peterzimon/shmoergh-dual-rail-psu/README.md

# +/-12V Dual rail power supply

Based on (Banana Schplit)[https://github.com/pms67/BananaSchplit] by Philip Salmony

# History

### v0.1-not-working

- well, it doesn't work. The layout is shit

### v1

- working version, using the exact same layout as Phil with Banana Schplit

#
