peterzimon/shmoergh-dual-rail-psu/v0.1-not-working/shmoergh-dual-rail-psu.kicad_pcb

## KiCad design v0.1-not-working/shmoergh-dual-rail-psu.kicad_pcb (2023-10-03)

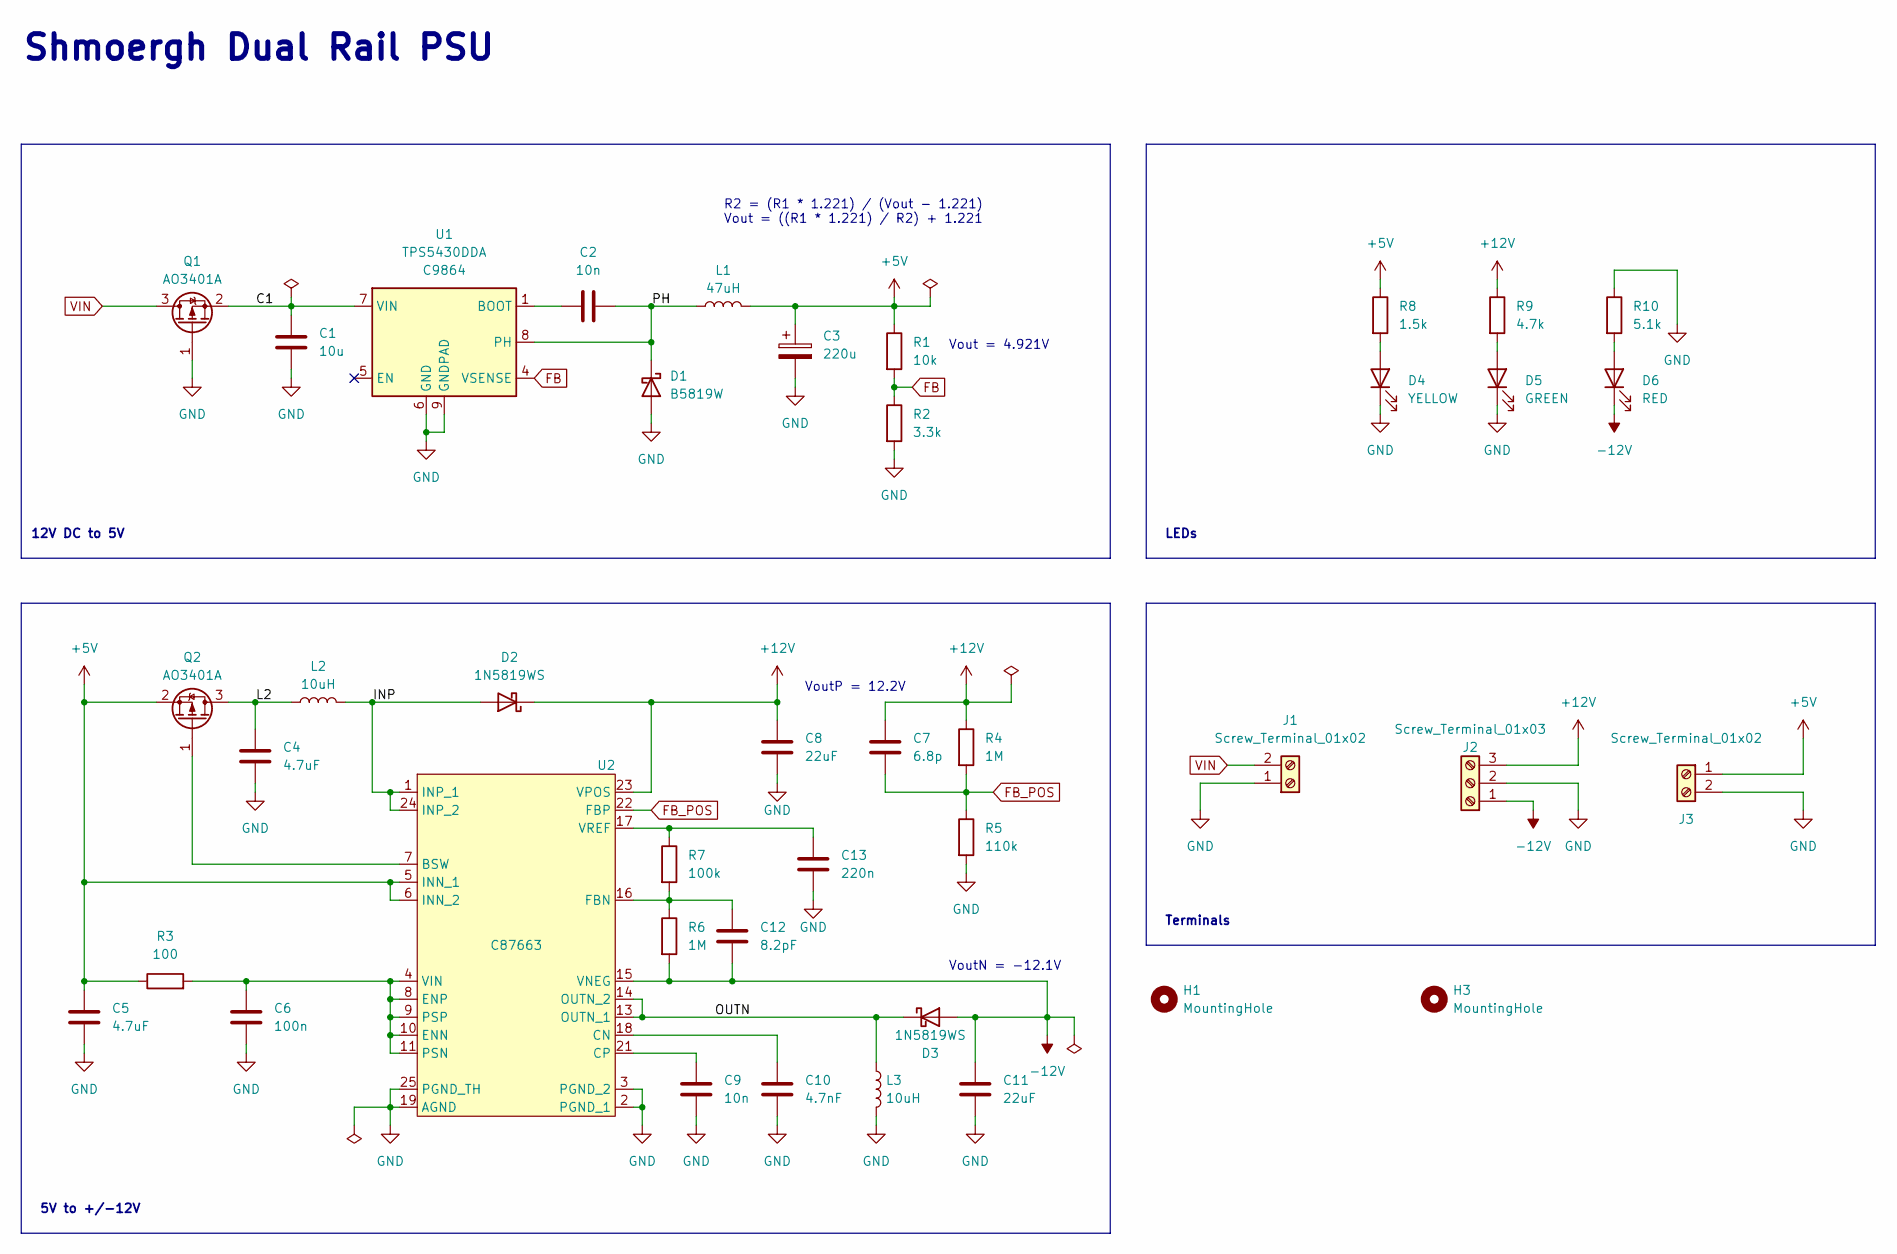
[picture p1: schematic shmoergh-dual-rail-psu.kicad_sch]

Parts:
C1: 10u; C_1206_3216Metric; LCSC C13585
C2: 10n; C_0402_1005Metric; LCSC C15195
C3: 220u; C_Elec_6.3x7.7; LCSC C127327
C4, C5: 4.7uF; C_0603_1608Metric; LCSC C19666
C6: 100n; C_0402_1005Metric; LCSC C307331
C7: 6.8p; R_0603_1608Metric; LCSC C1679
C8, C11: 22uF; C_0805_2012Metric; LCSC C45783
C9: 10n; C_0603_1608Metric; LCSC C57112
C10: 4.7nF; C_0603_1608Metric; LCSC C53987
C12: 8.2pF; C_0603_1608Metric; LCSC C1685
C13: 220n; C_0603_1608Metric; LCSC C21120
D1: B5819W; D_SOD-123; LCSC C8598
D2, D3: 1N5819WS; D_SOD-123; LCSC C191023
D4: YELLOW; LED_0603_1608Metric; LCSC C72038
D5: GREEN; LED_0603_1608Metric; LCSC C72043
D6: RED; LED_0603_1608Metric; LCSC C2286
H1, H3: MountingHole; MountingHole_3mm_Pad_Via
J1, J3: Screw_Terminal_01x02; TerminalBlock_Phoenix_MKDS-1,5-2_1x02_P5.00mm_Horizontal
J2: Screw_Terminal_01x03; TerminalBlock_Phoenix_MKDS-1,5-3_1x03_P5.00mm_Horizontal
L1: 47uH; L_Sunlord_SWRB1204S; LCSC C169398
L2, L3: 10uH; L_Sunlord_MWSA0518S; LCSC C177248
Q1, Q2: AO3401A; SOT-23; LCSC C15127
R1: 10k; R_0603_1608Metric; LCSC C25804
R2: 3.3k; R_0603_1608Metric; LCSC C22978
R3: 100; R_0603_1608Metric; LCSC C22775
R4, R6: 1M; R_0603_1608Metric; LCSC C22935
R5: 110k; R_0603_1608Metric; LCSC C25805
R7: 100k; R_0603_1608Metric; LCSC C25803
R8: 1.5k; R_0402_1005Metric; LCSC C25867
R9: 4.7k; R_0402_1005Metric; LCSC C25900
R10: 5.1k; R_0402_1005Metric; LCSC C25905
U1: TPS5430DDA; TI_SO-PowerPAD-8_ThermalVias; LCSC C9864
U2: TPS65131RGER; QFN-24-1EP_4x4mm_P0.5mm_EP2.6x2.6mm; LCSC C87663

Connections:
+5V: C3.1, C5.1, J3.1, L1.2, Q2.2 (S), R1.1, R3.1, R8.1, U2.5 (INN_1), U2.6 (INN_2)
+12V: C7.1, C8.1, D2.1 (K), J2.3, R4.1, R9.1, U2.23 (VPOS)
-12V: C11.1, C12.2, D3.2 (A), D6.1 (K), J2.1, R6.2, U2.15 (VNEG)
/C1: C1.1, Q1.2 (S), U1.7 (VIN)
/INP: D2.2 (A), L2.2, U2.1 (INP_1), U2.24 (INP_2)
/L2: C4.1, L2.1, Q2.3 (D)
/OUTN: D3.1 (K), L3.1, U2.13 (OUTN_1), U2.14 (OUTN_2)
/PH: C2.2, D1.1 (K), L1.1, U1.8 (PH)
FB: R1.2, R2.1, U1.4 (VSENSE)
FB_POS: C7.2, R4.2, R5.1, U2.22 (FBP)
GND: C1.2, C3.2, C4.2, C5.2, C6.2, C8.2, C9.2, C10.2, C11.2, C13.2, D1.2 (A), D4.1 (K), D5.1 (K), J1.1, J2.2, J3.2, L3.2, Q1.1 (G), R2.2, R5.2, R10.1, U1.6 (GND), U1.9 (GNDPAD), U2.2 (PGND_1), U2.3 (PGND_2), U2.19 (AGND), U2.25 (PGND_TH)
unnamed: D4.2 (A), R8.2
unnamed: D5.2 (A), R9.2
unnamed: D6.2 (A), R10.2
unnamed: Q2.1 (G), U2.7 (BSW)
unnamed: C2.1, U1.1 (BOOT)
unnamed: C10.1, U2.18 (CN)
unnamed: C9.1, U2.21 (CP)
unnamed: C6.1, R3.2, U2.4 (VIN), U2.8 (ENP), U2.9 (PSP), U2.10 (ENN), U2.11 (PSN)
unnamed: C12.1, R6.1, R7.2, U2.16 (FBN)
unnamed: C13.1, R7.1, U2.17 (VREF)
VIN: J1.2, Q1.3 (D)

Notes on the sheet:
R2 = (R1 * 1.221) / (Vout - 1.221) Vout = ((R1 * 1.221) / R2) + 1.221
Terminals
VoutN = -12.1V
LEDs
Vout = 4.921V
VoutP = 12.2V
12V DC to 5V
5V to +/-12V
Shmoergh Dual Rail PSU

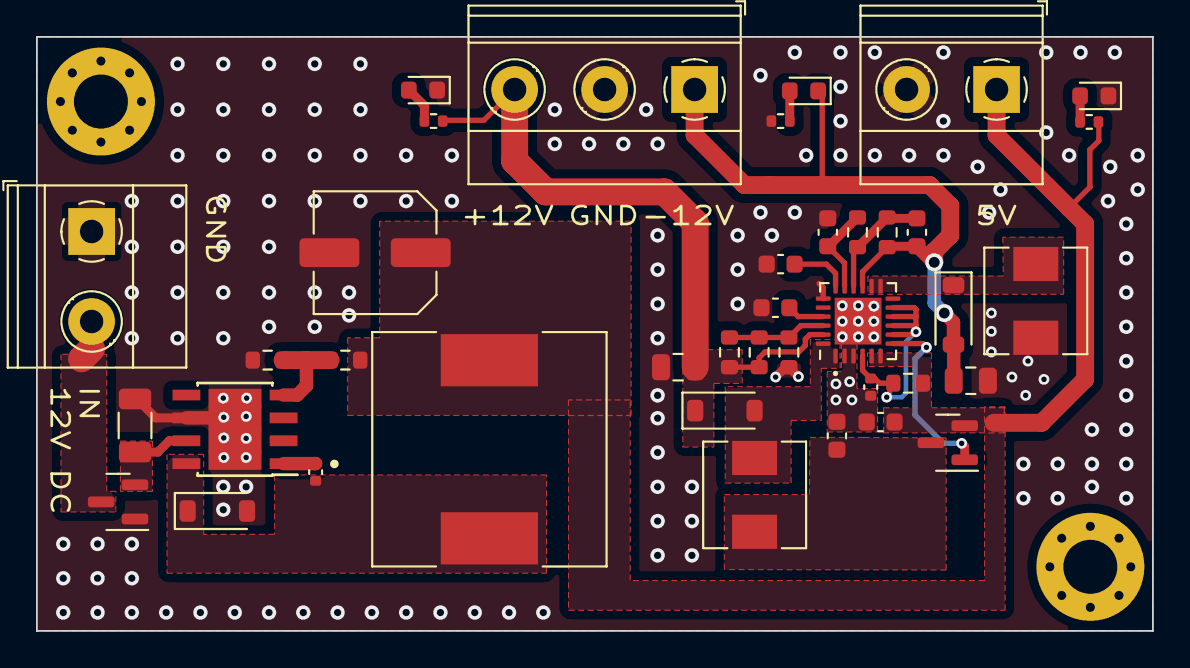
[picture p2: board v0.1-not-working/shmoergh-dual-rail-psu.kicad_pcb from above]

Board: 2 copper layers, 62.0 x 33.0 mm, 41 parts (0 on the bottom side), 22 nets.
