peterzimon/shmoergh-dual-rail-psu/v1/shmoergh-dual-rail-psu.kicad_pcb

## KiCad design v1/shmoergh-dual-rail-psu.kicad_pcb (2023-11-18)

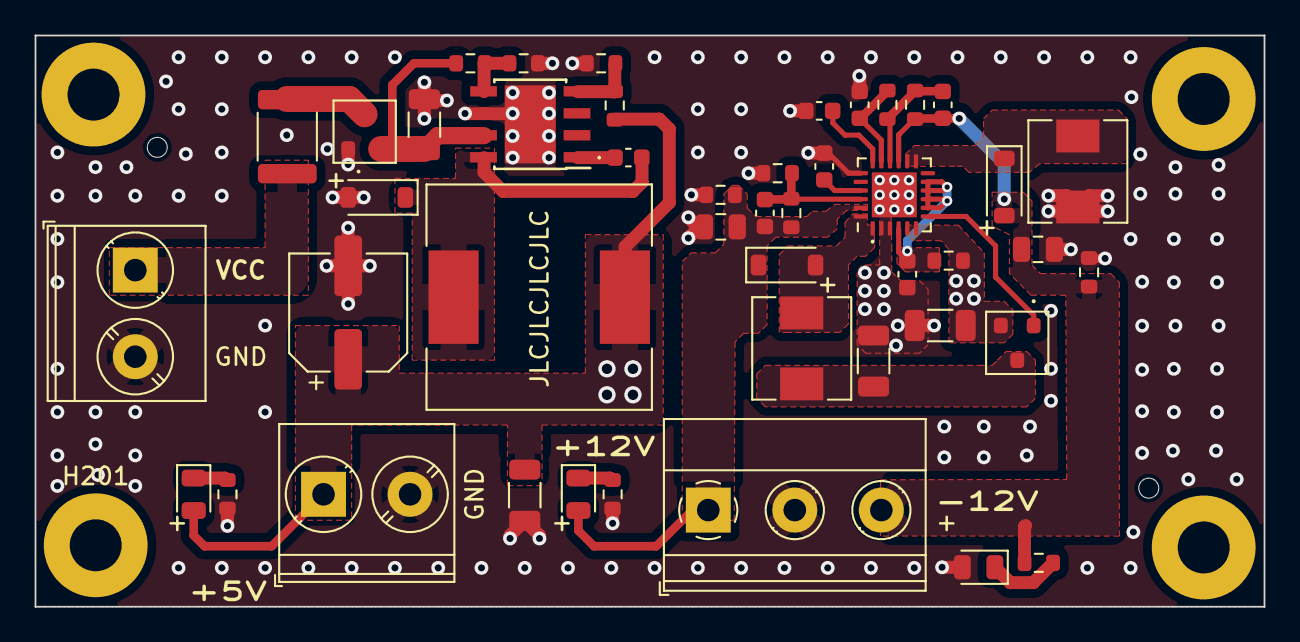
[picture p3: board v1/shmoergh-dual-rail-psu.kicad_pcb from above]

Board: 4 copper layers, 71.0 x 33.0 mm, 49 parts (0 on the bottom side), 24 nets.

Parts:
C101, C102, C103, C107: 10u; C_1206_3216Metric
C104: 100n; C_0603_1608Metric
C105, C106: 10n; C_0603_1608Metric
C108: 6p8; C_0603_1608Metric
C109: 8p2; C_0603_1608Metric
C110: 220u; CP_Elec_6.3x7.7
C111: 220n; C_0603_1608Metric
C112, C113: 22u; C_0805_2012Metric
C114: 4n7; C_0603_1608Metric
D101, D102, D103: B5819W; D_SOD-123
D104: RED; LED_0805_2012Metric
D105: GREEN; LED_0805_2012Metric
D106: YELLOW; LED_0805_2012Metric
F101: 500mA; Fuse_1812_4532Metric
H201, H202, H203, H204: MountingHole; MountingHole_3mm_Pad
J101, J103: Screw_Terminal_01x02; TerminalBlock_Phoenix_PT-1,5-2-5.0-H_1x02_P5.00mm_Horizontal
J102: Screw_Terminal_01x03; TerminalBlock_Phoenix_MKDS-1,5-3_1x03_P5.00mm_Horizontal
L101, L103: 10u; L_Sunlord_MWSA0518S
L102: 47u; L_Sunlord_SWRB1204S
Q101, Q102: AO3401A; SOT-23
R101: 100; R_0603_1608Metric
R102, R103, R106: 100k; R_0603_1608Metric
R104, R107: 1M; R_0603_1608Metric
R105: 110k; R_0603_1608Metric
R108: 10k; R_0603_1608Metric
R109: 3k3; R_0603_1608Metric
R110, R111: 12k; R_0603_1608Metric
R112: 1k5; R_0603_1608Metric
R113: 4k3; R_0603_1608Metric
R114: 5k1; R_0603_1608Metric
U101: TPS65131RGER; QFN-24-1EP_4x4mm_P0.5mm_EP2.6x2.6mm
U102: TPS5430DDA; TI_SO-PowerPAD-8_ThermalVias

Connections:
+5V: C101.1, C107.1, C110.1, D104.2 (A), J103.1, L102.2, Q102.2 (S), R101.2, R108.2, U101.5 (INN_1), U101.6 (INN_2)
+12V: C108.1, C113.1, D101.1 (K), D105.2 (A), J102.1, R104.2, R111.2, U101.23 (VPOS)
-12V: C109.2, C112.1, D103.2 (A), J102.3, R107.1, R110.2, R114.1, U101.15 (VNEG)
GND: C101.2, C102.2, C103.2, C104.2, C106.2, C107.2, C110.2, C111.2, C112.2, C113.2, C114.2, D102.2 (A), D106.2 (A), J101.2, J102.2, J103.2, L103.2, Q101.1 (G), R103.1, R105.1, R109.1, R110.1, R111.1, R112.1, R113.1, U101.2 (PGND_1), U101.3 (PGND_2), U101.19 (AGND), U101.25 (POWERPAD), U102.6 (GND), U102.9 (GNDPAD)
unnamed: D101.2 (A), L101.2, U101.1 (INP_1), U101.24 (INP_2)
unnamed: C105.2, D102.1 (K), L102.1, U102.8 (PH)
unnamed: D103.1 (K), L103.1, U101.13 (OUTN_1), U101.14 (OUTN_2)
unnamed: D104.1 (K), R112.2
unnamed: D105.1 (K), R113.2
unnamed: D106.1 (K), R114.2
unnamed: F101.1, Q101.3 (D)
unnamed: C102.1, Q101.2 (S), R102.2, U102.7 (VIN)
unnamed: C103.1, L101.1, Q102.3 (D)
unnamed: Q102.1 (G), U101.7 (BSW)
unnamed: C114.1, U101.18 (CN)
unnamed: C106.1, U101.21 (CP)
unnamed: C104.1, R101.1, U101.4 (VIN), U101.8 (ENP), U101.9 (PSP), U101.10 (ENN), U101.11 (PSN)
unnamed: C109.1, R106.1, R107.2, U101.16 (FBN)
unnamed: C108.2, R104.1, R105.2, U101.22 (FBP)
unnamed: C111.1, R106.2, U101.17 (VREF)
unnamed: C105.1, U102.1 (BOOT)
unnamed: R102.1, R103.2, U102.5 (EN)
PSU_FB: R108.1, R109.2, U102.4 (VSENSE)
VCC: F101.2, J101.1
