peterzimon/shmoergh-dual-rail-psu/(commit log)

2023-09-28 Added schematics and PCB
    [shmoergh-dual-rail-psu.kicad_pcb, shmoergh-dual-rail-psu.kicad_sch]
2023-10-03 Component update
    [shmoergh-dual-rail-psu-B_Cu.gbl, shmoergh-dual-rail-psu-B_Mask.gbs, shmoergh-dual-rail-psu-B_Paste.gbp, shmoergh-dual-rail-psu-B_Silkscreen.gbo, shmoergh-dual-rail-psu-Edge_Cuts.gm1, shmoergh-dual-rail-psu-F_Cu.gtl, shmoergh-dual-rail-psu-F_Mask.gts, shmoergh-dual-rail-psu-F_Paste.gtp]
2023-11-18 Added working version v1
    [psu.kicad_sch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]
